umeiko/rpi2040-heimann-htpa32x32d-touchscreen/stl/button_x3.stl

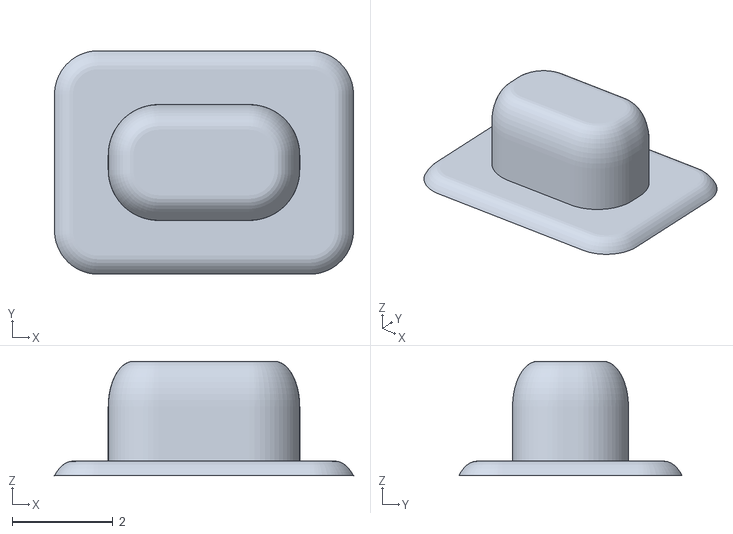
[picture p2: CAD file, 2025-01-20]
stl/button_x3.stl
5.93 x 4.43 x 2.27
