umeiko/rpi2040-heimann-htpa32x32d-touchscreen/stl/switch_x1.STL

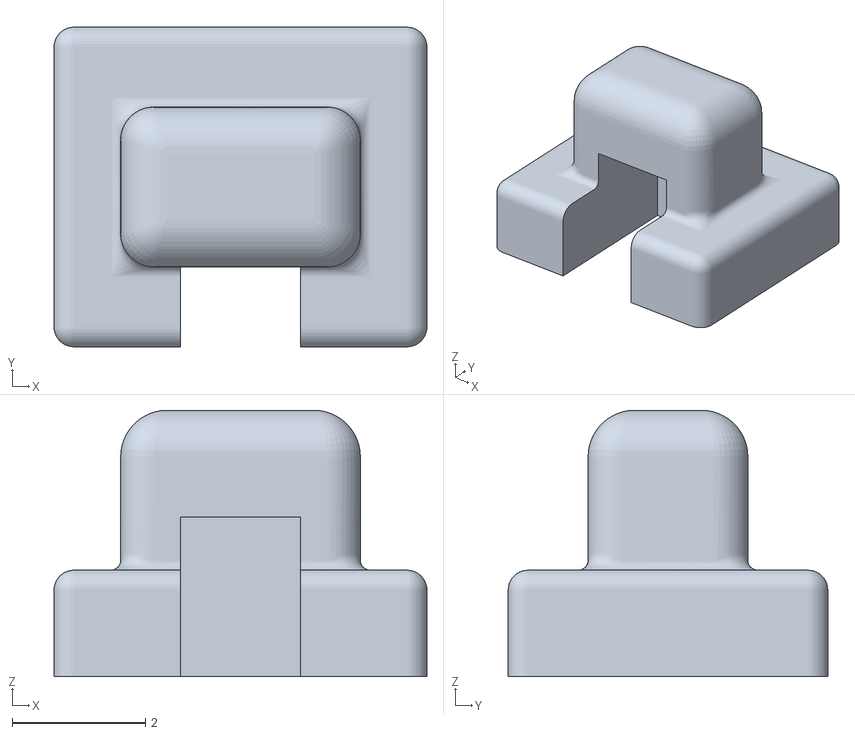
[picture p3: CAD file, 2025-01-20]
stl/switch_x1.STL
5.60 x 4.80 x 4.00
