umeiko/rpi2040-heimann-htpa32x32d-touchscreen/stl/shell2040_HAM.STL

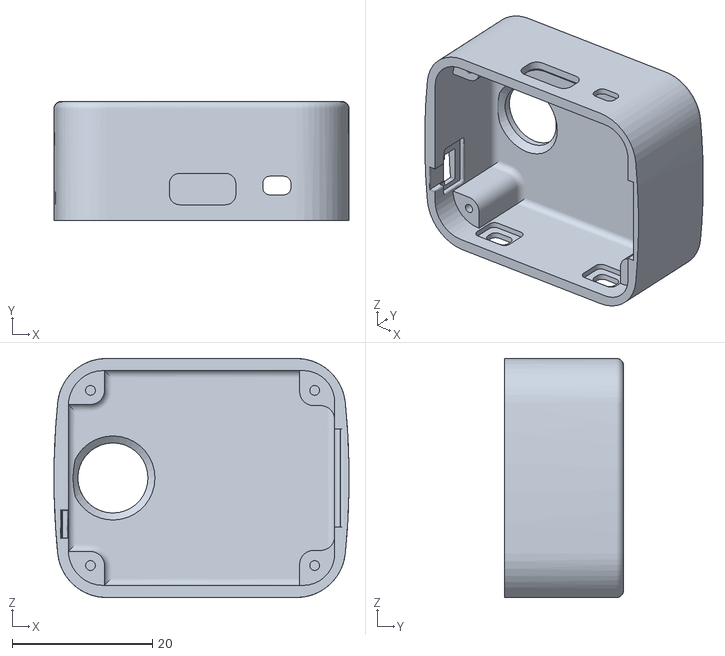
[picture p4: CAD file, 2025-01-20]
stl/shell2040_HAM.STL
42.1 x 17.0 x 34.1
