umeiko/rpi2040-heimann-htpa32x32d-touchscreen/stl/MLX垫子.STL

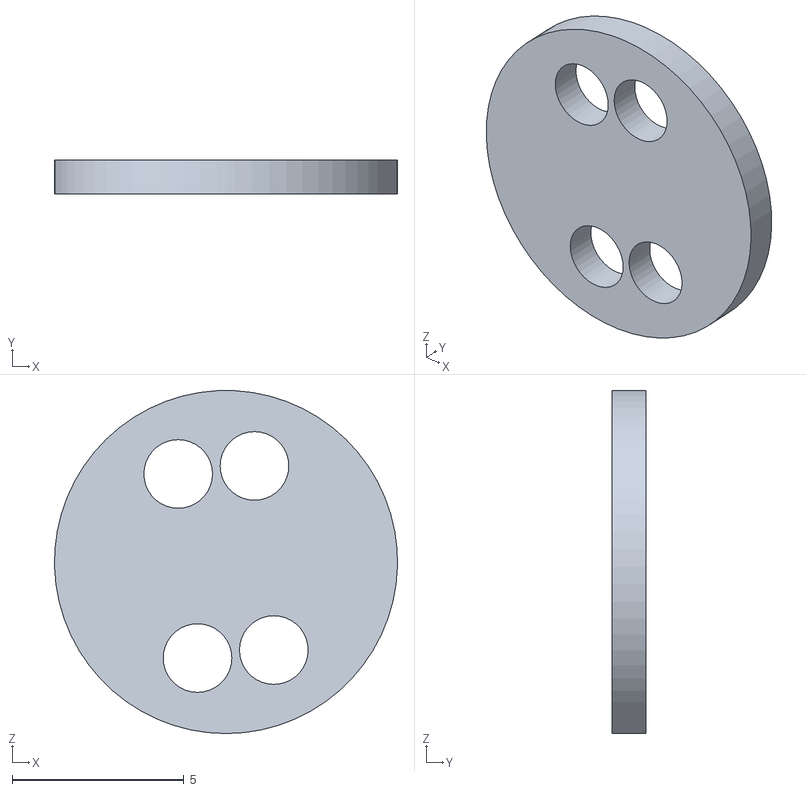
[picture p5: CAD file, 2025-01-20]
stl/MLX垫子.STL
10.00 x 1.00 x 10.0
