umeiko/rpi2040-heimann-htpa32x32d-touchscreen/pcb/Schematic.pdf

## Raspberry Pi

晶振

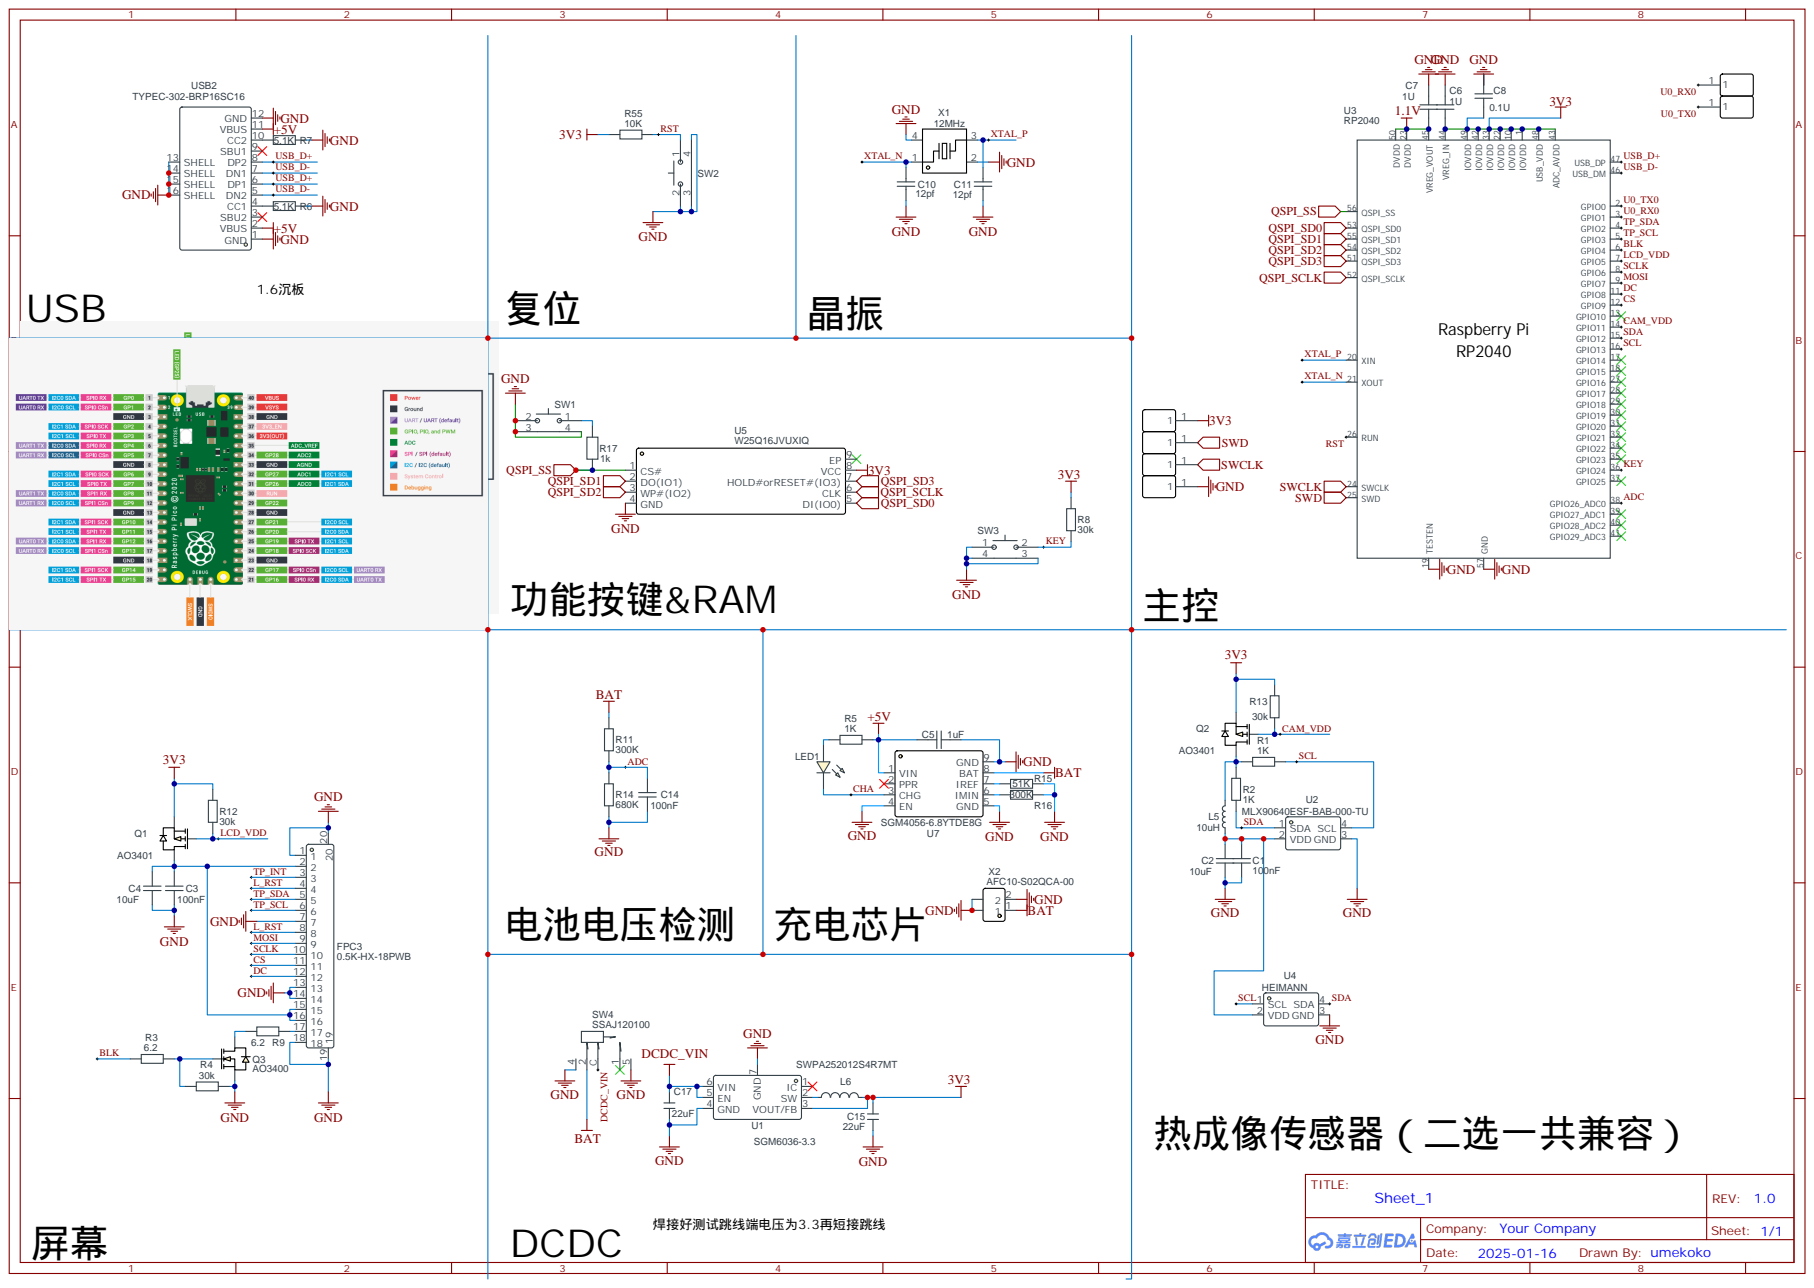
[picture p6: page 1]

SHELL 16 SHELL 15 SHELL 14 SHELL 13
