umeiko/rpi2040-heimann-htpa32x32d-touchscreen/(list of files, drawings)

Other design files:
pcb/PCB.pcbdoc
