umeiko/rpi2040-heimann-htpa32x32d-touchscreen/main/src/probe/def.h

#ifndef _def_H
#define _def_H

#include <Arduino.h>
// DEVICE ADRESS
#define  SENSOR_ADDRESS          0x1A
#define  EEPROM_ADDRESS          0x50

// I2C CLOCK
#define CLOCK_SENSOR            1000000 
#define CLOCK_EEPROM            400000


// SETTING
#define PTAT_BUFFER_SIZE 10
#define VDD_BUFFER_SIZE 10
#define ELOFFSETS_BUFFER_SIZE 10
#define ELOFFSETS_FILTER_START_DELAY  100
#define START_WITH_BLOCK 4
#define READ_ELOFFSET_EVERYX 10

// PARAMETER LOOKUPTABLE
#define TABLENUMBER 113      // table number of this sensor type
#define PCSCALEVAL 100000000 // scale value for PixC (see formula in datasheet)
#define NROFTAELEMENTS 7    // number of columns (ambient temperature steps)
#define NROFADELEMENTS 1595  // number of rows (digit steps)
#define TAEQUIDISTANCE 100   // distance between two columns
#define ADEQUIDISTANCE 64    // distance between two rows
#define ADEXPBITS 6
#define TABLEOFFSET 1024 // table offset in digits


// SENSOR INFO
#define NUMBER_OF_PIXEL 1024 // number of all pixels
#define NUMBER_OF_BLOCKS 4 // number of blocks for each half
#define PIXEL_PER_BLOCK 128 // number of pixels of each block
#define PIXEL_PER_COLUMN 32 // number of pixels of each column
#define PIXEL_PER_ROW 32 // number of pixels of each row
#define ROW_PER_BLOCK 4 // number of rows of each block
#define ALLOWED_DEADPIX 5 // max. 0.5% of the pixel number
#define ATC_ACTIVE 0 // 1 - sensor has... / 0 - sensor hasn't a cyclops
#define ATC_POS 0 // postion of the cyclops in block reading order
#define PTAT_POS 0 // position of PTAT in block reading order
#define VDD_POS 0 // postion of VDD in block reading order
#define PTAT_VDD_SWITCH 1 // 1 - PTAT and VDD alternate after each pic / 0 - not
#define BLOCK_LENGTH 258 // number of char in each block
#define DATA_POS 2  // position of first data byte in each block


// SENSOR REGISTER
#define TOP_HALF 0x0A // data of top half
#define BOTTOM_HALF 0x0B // data of bot half
#define CONFIGURATION_REGISTER 0x01 // configuration register (WRITE only)
// |  7  |  6  |  5  |  4  |   3   |    2     |   1   |    0   |
// |    RFU    |   Block   | Start | VDD_MEAS | BLIND | WAKEUP |
#define STATUS_REGISTER 0x02 // adress of status register (READ only)
// |  7  |  6  |  5  |  4  |   3   |    2     |   1   |    0   |
// |    RFU    |   Block   |  RFU  | VDD_MEAS | BLIND |   EOC  |
#define TRIM_REGISTER1 0x03 // adress for trim register 1 (WRITE only)
// |  7  |  6  |  5  |  4  |  3  |  2  |  1  |  0  |
// |    RFU    |  REF_CAL  |         MBIT          |
#define TRIM_REGISTER2 0x04 // adress for trim register 2 (WRITE only)
// |  7  |  6  |  5  |  4  |  3  |  2  |  1  |  0  |
// |       RFU       |       BIAS TRIM TOP         |
#define TRIM_REGISTER3 0x05 // adress for trim register 3 (WRITE only)
// |  7  |  6  |  5  |  4  |  3  |  2  |  1  |  0  |
// |       RFU       |       BIAS TRIM BOT         |
#define TRIM_REGISTER4 0x06 // adress for trim register 4 (WRITE only)
// |  7  |  6  |  5  |  4  |  3  |  2  |  1  |  0  |
// |       RFU |             CLK TRIM              |
#define TRIM_REGISTER5 0x07 // adress for trim register 5 (WRITE only)
// |  7  |  6  |  5  |  4  |  3  |  2  |  1  |  0  |
// |       RFU       |        BPA TRIM TOP         |
#define TRIM_REGISTER6 0x08 // adress for trim register 6 (WRITE only)
// |  7  |  6  |  5  |  4  |  3  |  2  |  1  |  0  |
// |       RFU       |       BPA TRIM BOT          |
#define TRIM_REGISTER7 0x09 // adress for trim register 7 (WRITE only)
// |  7  |  6  |  5  |  4  |  3  |  2  |  1  |  0  |
// |       PU SDA TRIM     |       PU SDA TRIM     |


// EEPROM REGISTER
#define E_PIXCMIN_1 0x0000 // Min of PixC, stored as float in four 8-bit fields
#define E_PIXCMIN_2 0x0001
#define E_PIXCMIN_3 0x0002
#define E_PIXCMIN_4 0x0003
#define E_PIXCMAX_1 0x0004// Max of PixC, stored as float in four 8-bit fields
#define E_PIXCMAX_2 0x0005
#define E_PIXCMAX_3 0x0006
#define E_PIXCMAX_4 0x0007
#define E_GRADSCALE 0x0008 // stored as unsigned char, important for PTAT comp.
#define E_TABLENUMBER1 0x000B // table number of this sensor, stored as unsigned short
#define E_TABLENUMBER2 0x000C
#define E_EPSILON 0x000D // emissivity in percentage, stored as unsigned char
#define E_MBIT_CALIB 0x001A // calibration settings of trim register 1
#define E_BIAS_CALIB 0x001B // calibration settings of trim register 2 & 3
#define E_CLK_CALIB 0x001C // calibration settings of trim register 4
#define E_BPA_CALIB 0x001D // calibration settings of trim register 5 & 6
#define E_PU_CALIB 0x001E // calibration settings of trim register 7
#define E_ARRAYTYPE 0x0022 // array type of this sensor
#define E_VDDTH1_1 0x0026 // HS calibration value
#define E_VDDTH1_2 0x0027 // HS calibration value
#define E_VDDTH2_1 0x0028 // HS calibration value
#define E_VDDTH2_2 0x0029 // HS calibration value
#define E_PTATGR_1 0x0034 // PTAT gradient stored as float in four 8-bit fields
#define E_PTATGR_2 0x0035
#define E_PTATGR_3 0x0036
#define E_PTATGR_4 0x0037
#define E_PTATOFF_1 0x0038 // PTAT offset stored as float in four 8-bit fields
#define E_PTATOFF_2 0x0039
#define E_PTATOFF_3 0x003A
#define E_PTATOFF_4 0x003B
#define E_PTATTH1_1 0x003C // HS calibration value
#define E_PTATTH1_2 0x003D // HS calibration value
#define E_PTATTH2_1 0x003E // HS calibration value
#define E_PTATTH2_2 0x003F // HS calibration value
#define E_VDDSCGRAD 0x004E // HS calibration value
#define E_VDDSCOFF 0x004F // HS calibration value
#define E_GLOBALOFF 0x0054 // global offset, stored as signed char
#define E_GLOBALGAIN_1 0x0055 // global gain, stored as unsigned short
#define E_GLOBALGAIN_2 0x0056
#define E_MBIT_USER 0x0060 // user settings of trim register 1
#define E_BIAS_USER 0x0061 // user settings of trim register 2 & 3
#define E_CLK_USER 0x0062 // user settings of trim register 4
#define E_BPA_USER 0x0063 // user settings of trim register 5 & 6
#define E_PU_USER 0x0064 // user settings of trim register 7
#define E_ID1 0x0074 // sensor idenification number, stored as unsigned long (1 of 4)
#define E_ID2 0x0075
#define E_ID3 0x0076
#define E_ID4 0x0077
#define E_NROFDEFPIX 0x007F // number of defekt pixel, stored as unsigned char
#define E_DEADPIXADR 0x0080 // first register of dead adress
#define E_DEADPIXMASK 0x00B0 // first register of dead pixel mask
#define E_VDDCOMPGRAD 0x0340 // first register of VDD comp gradient
#define E_VDDCOMPOFF 0x0540 // first register ofVDD comp offset
#define E_THGRAD 0x0740 // first register of thermal gradient
#define E_THOFFSET 0x0F40 // first register of thermal offset 
#define E_PIJ 0x1740 // first register of pixel constants (PixC)
#define EEPROM_SIZE 0x2000 // total number of EEPROM bytes

const unsigned char LUTshape[8][8] = {
  {0,0,0,0,0,0,0,0},
  {1,1,1,1,0,0,0,1},
  {0,1,0,0,0,0,0,1},
  {0,1,0,1,0,1,0,1},
  {0,1,0,1,0,1,0,1},
  {0,1,0,1,1,1,0,1},
  {0,1,0,0,0,0,0,1},
  {0,1,0,1,1,1,1,1},
};


const unsigned int TempTable [NROFADELEMENTS][NROFTAELEMENTS]={
{  0x0000, 0x0000, 483,  1384, 1759, 2037, 2269  },
{ 0x0000, 0x0000, 1183, 1621, 1920, 2162, 2372  },
{ 0x0000, 942,  1481, 1805, 2058, 2274, 2466  },
{ 567,  1340, 1694, 1959, 2181, 2376, 2555  },
{ 1201, 1589, 1865, 2092, 2291, 2471, 2638  },
{ 1492, 1779, 2011, 2211, 2392, 2559, 2716  },
{ 1703, 1937, 2138, 2319, 2485, 2641, 2790  },
{ 1872, 2073, 2252, 2418, 2572, 2719, 2860  },
{ 2017, 2194, 2356, 2509, 2654, 2793, 2927  },
{ 2144, 2303, 2452, 2595, 2731, 2863, 2992  },
{ 2257, 2403, 2542, 2675, 2805, 2930, 3053  },
{ 2361, 2496, 2625, 2751, 2874, 2995, 3113  },
{ 2457, 2582, 2704, 2824, 2941, 3056, 3170  },
{ 2546, 2663, 2779, 2892, 3005, 3116, 3226  },
{ 2629, 2740, 2850, 2958, 3066, 3173, 3279  },
{ 2708, 2813, 2917, 3021, 3125, 3228, 3331  },
{ 2782, 2882, 2982, 3082, 3182, 3282, 3382  },
{ 2853, 2948, 3044, 3140, 3237, 3334, 3431  },
{ 2920, 3012, 3104, 3197, 3290, 3384, 3479  },
{ 2985, 3073, 3162, 3252, 3342, 3433, 3525  },
{ 3047, 3132, 3217, 3304, 3392, 3481, 3571  },
{ 3107, 3188, 3271, 3356, 3441, 3528, 3615  },
{ 3164, 3243, 3324, 3406, 3489, 3573, 3659  },
{ 3220, 3296, 3374, 3454, 3535, 3617, 3701  },
{ 3274, 3348, 3424, 3501, 3580, 3661, 3742  },
{ 3326, 3398, 3472, 3547, 3624, 3703, 3783  },
{ 3377, 3447, 3518, 3592, 3667, 3744, 3823  },
{ 3426, 3494, 3564, 3636, 3710, 3785, 3862  },
{ 3474, 3540, 3609, 3679, 3751, 3824, 3900  },
{ 3521, 3585, 3652, 3721, 3791, 3863, 3937  },
{ 3566, 3629, 3694, 3762, 3831, 3902, 3974  },
{ 3611, 3672, 3736, 3802, 3870, 3939, 4010  },
{ 3654, 3714, 3777, 3841, 3908, 3976, 4046  },
{ 3696, 3755, 3817, 3880, 3945, 4012, 4081  },
{ 3738, 3796, 3856, 3918, 3982, 4048, 4115  },
{ 3779, 3835, 3894, 3955, 4018, 4083, 4149  },
{ 3818, 3874, 3932, 3991, 4053, 4117, 4183  },
{ 3857, 3912, 3969, 4027, 4088, 4151, 4215  },
{ 3896, 3949, 4005, 4063, 4122, 4184, 4248  },
{ 3933, 3986, 4041, 4097, 4156, 4217, 4280  },
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


const unsigned int XTATemps[NROFTAELEMENTS]={2782,  2882, 2982, 3082, 3182, 3282, 3382};
const unsigned int YADValues[NROFADELEMENTS]={0,  64, 128,  192,  256,  320,  384,  448,  512,  576,  640,  704,  768,  832,  896,  960,  1024, 1088, 1152, 1216, 1280, 1344, 1408, 1472, 1536, 1600, 1664, 1728, 1792, 1856, 1920, 1984, 2048, 2112, 2176, 2240, 2304, 2368, 2432, 2496, 2560, 2624, 2688, 2752, 2816, 2880, 2944, 3008, 3072, 3136, 3200, 3264, 3328, 3392, 3456, 3520, 3584, 3648, 3712, 3776, 3840, 3904, 3968, 4032, 4096, 4160, 4224, 4288, 4352, 4416, 4480, 4544, 4608, 4672, 4736, 4800, 4864, 4928, 4992, 5056, 5120, 5184, 5248, 5312, 5376, 5440, 5504, 5568, 5632, 5696, 5760, 5824, 5888, 5952, 6016, 6080, 6144, 6208, 6272, 6336, 6400, 6464, 6528, 6592, 6656, 6720, 6784, 6848, 6912, 6976, 7040, 7104, 7168, 7232, 7296, 7360, 7424, 7488, 7552, 7616, 7680, 7744, 7808, 7872, 7936, 8000, 8064, 8128, 8192, 8256, 8320, 8384, 8448, 8512, 8576, 8640, 8704, 8768, 8832, 8896, 8960, 9024, 9088, 9152, 9216, 9280, 9344, 9408, 9472, 9536, 9600, 9664, 9728, 9792, 9856, 9920, 9984, 10048,  10112,  10176,  10240,  10304,  10368,  10432,  10496,  10560,  10624,  10688,  10752,  10816,  10880,  10944,  11008,  11072,  11136,  11200,  11264,  11328,  11392,  11456,  11520,  11584,  11648,  11712,  11776,  11840,  11904,  11968,  12032,  12096,  12160,  12224,  12288,  12352,  12416,  12480,  12544,  12608,  12672,  12736,  12800,  12864,  12928,  12992,  13056,  13120,  13184,  13248,  13312,  13376,  13440,  13504,  13568,  13632,  13696,  13760,  13824,  13888,  13952,  14016,  14080,  1414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
98176,  98240,  98304,  98368,  98432,  98496,  98560,  98624,  98688,  98752,  98816,  98880,  98944,  99008,  99072,  99136,  99200,  99264,  99328,  99392,  99456,  99520,  99584,  99648,  99712,  99776,  99840,  99904,  99968,  100032, 100096, 100160, 100224, 100288, 100352, 100416, 100480, 100544, 100608, 100672, 100736, 100800, 100864, 100928, 100992, 101056, 101120, 101184, 101248, 101312, 101376, 101440, 101504, 101568, 101632, 101696, 101760, 101824, 101888, 101952, 102016};



// const unsigned short DLCOFFSET_LUT[10000] = { 0,  0,  0,  0,  0,  0,  0,  0,  0,  0,  0,  0,  0,  0,  0,  0,  0,  0,  0,  0,  0,  0,  0,  0,  0,  0,  0,  0,  0,  0,  0,  0,  0,  0,  0,  0,  0,  0,  0,  0,  0,  0,  0,  0,  0,  0,  0,  0,  0,  0,  0,  0,  0,  0,  0,  0,  0,  0,  0,  0,  0,  0,  0,  0,  0,  0,  0,  0,  0,  0,  0,  0,  0,  0,  0,  0,  0,  0,  0,  0,  0,  0,  0,  0,  0,  0,  0,  0,  0,  0,  0,  0,  0,  0,  0,  1,  1,  1,  1,  1,  1,  1,  1,  1,  1,  1,  1,  1,  1,  1,  1,  1,  1,  1,  1,  1,  1,  1,  1,  1,  1,  1,  1,  1,  1,  1,  1,  1,  1,  1,  1,  1,  1,  1,  1,  1,  1,  1,  1,  1,  1,  1,  1,  1,  1,  1,  1,  1,  1,  1,  1,  1,  1,  1,  1,  1,  1,  1,  1,  1,  1,  1,  1,  1,  1,  1,  1,  1,  1,  1,  1,  1,  1,  1,  1,  1,  1,  1,  1,  1,  1,  1,  1,  1,  1,  1,  1,  1,  1,  1,  1,  1,  1,  1,  1,  1,  1,  1,  1,  1,  1,  1,  1,  1,  1,  1,  1,  1,  1,  1,  1,  1,  1,  1,  1,  1,  1,  1,  1,  1,  1,  1,  1,  1,  1,  1,  1,  1,  1,  1,  1,  2,  2,  2,  2,  2,  2,  2,  2,  2,  2,  2,  2,  2,  2,  2,  2,  2,  2,  2,  2,  2,  2,  2,  2,  2,  2,  2,  2,  2,  2,  2,  2,  2,  2,  2,  2,  2,  2,  2,  2,  2,  2,  2,  2,  2,  2,  2,  2,  2,  2,  2,  2,  2,  2,  2,  2,  2,  2,  2,  2,  2,  2,  2,  2,  2,  2,  2,  2,  2,  2,  2,  2,  2,  2,  2,  2,  2,  2,  2,  2,  2,  2,  2,  2,  2,  2,  2,  2,  2,  2,  2,  2,  2,  2,  2,  2,  2,  2,  2,  2,  2,  2,  2,  2,  2,  2,  2,  2,  2,  2,  2,  2,  2,  2,  2,  2,  2,  2,  2,  2,  2,  2,  2,  2,  2,  3,  3,  3,  3,  3,  3,  3, 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


#endif // for #ifndef  _def_H
