umeiko/rpi2040-heimann-htpa32x32d-touchscreen/main/src/colormap.h

// 这里保存了热力图的颜色表，格式为rgb565
/*** PROGRAMM INFO***************************************************************************************
  source code for color mapping
  name:           colormap.h
  version/date:   0.0.1 / 01 Jan 2025
  programmer:     Umeko (umeko@stu.xmu.edu.cn)
*********************************************************************************************************/
#ifndef COLORMAP_H
#define COLORMAP_H

#include <Arduino.h>
#include "shared_val.h"

static uint16_t colormap[180];

uint16_t viridis[180] PROGMEM = {
0x400a, 0x400a, 0x400a, 0x400a, 0x400a, 0x400a, 0x402b, 0x402b, 0x404b, 0x404b, 
0x404b, 0x406b, 0x406b, 0x406c, 0x406c, 0x408c, 0x408c, 0x408c, 0x40ac, 0x40ac, 
0x40ad, 0x40ad, 0x48cd, 0x48cd, 0x48cd, 0x48cd, 0x48ed, 0x48ee, 0x48ee, 0x490e, 
0x490e, 0x490e, 0x490e, 0x490e, 0x490e, 0x412e, 0x412e, 0x412e, 0x414f, 0x414f, 
0x414f, 0x414f, 0x416f, 0x416f, 0x416f, 0x418f, 0x418f, 0x418f, 0x418f, 0x41af, 
0x41af, 0x41b0, 0x41b0, 0x41b0, 0x41d0, 0x41d0, 0x41d0, 0x41d0, 0x41f0, 0x41f0, 
0x41f0, 0x41f0, 0x4210, 0x4210, 0x4210, 0x4210, 0x4210, 0x4230, 0x4230, 0x3a31, 
0x3a31, 0x3a51, 0x3a51, 0x3a51, 0x3a51, 0x3a51, 0x3a71, 0x3a71, 0x3a71, 0x3a71, 
0x3a91, 0x3a91, 0x3a91, 0x3a91, 0x3a91, 0x3ab1, 0x3ab1, 0x3ab1, 0x3ab1, 0x3ab1, 
0x32d1, 0x32d1, 0x32d1, 0x32f1, 0x3311, 0x3311, 0x3331, 0x3331, 0x3351, 0x2b51, 
0x2b71, 0x2b71, 0x2b91, 0x2b91, 0x2bb1, 0x2bb1, 0x2bd1, 0x2bd1, 0x23f1, 0x23f1, 
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
0x4a69, 0x4a49, 0x4a49, 0x4228, 0x4228, 0x4208, 0x39e7, 0x39c7, 0x31a6, 0x31a6, 
0x3186, 0x2965, 0x2945, 0x2945, 0x2945, 0x2104, 0x2104, 0x18e3, 0x18e3, 0x18c3, 
0x18c3, 0x10a2, 0x1082, 0x1082, 0x0861, 0x0861, 0x0841, 0x0841, 0x0020, 0x0000
};

// 根据索引从程序存储器中复制数据到静态数组
void load_colormap(uint8_t index) {
    cmap_loading_lock = true;
    if (index == COLORMAP_CLASSIC) {
        memcpy_P(colormap, classic, sizeof(colormap));
    }else if (index == COLORMAP_VIRIDIS) {
        memcpy_P(colormap, viridis, sizeof(colormap));
    }else if(index == COLORMAP_HOT) {
        memcpy_P(colormap, hot, sizeof(colormap));
    }else if(index == COLORMAP_TURBO) {
        memcpy_P(colormap, turbo, sizeof(colormap));
    }else if(index == COLORMAP_INFERNO) {
        memcpy_P(colormap, inferno, sizeof(colormap));
    }else if(index == COLORMAP_GRAYSR) {
        memcpy_P(colormap, greys_r, sizeof(colormap));
    }else if(index == COLORMAP_GRAYS) {
        memcpy_P(colormap, greys, sizeof(colormap));
    }else{
        memcpy_P(colormap, classic, sizeof(colormap));
    }
    cmap_loading_lock = false;
}

void next_cmap(){
    cmap_now_choose+=1;
    if (cmap_now_choose>=COLORMAP_GRAYS){
        cmap_now_choose = COLORMAP_CLASSIC;
    }
    load_colormap(cmap_now_choose);
}

void priv_cmap(){
    if (cmap_now_choose==COLORMAP_CLASSIC){
        cmap_now_choose = COLORMAP_GRAYS;
    }else{
        cmap_now_choose-=1;
    }
    load_colormap(cmap_now_choose);
}

#endif // COLORMAP_H
