umeiko/rpi2040-heimann-htpa32x32d-touchscreen/main/src/logo_jpg.h

/*  Create C arrays from jpeg images
    If needed, first resize and crop to an appropriate width and height
    to suit your display with an image editing program such as IrfanView.
    You can also change the image "quality" to reduce the file size.
    Paste the array into a new tab, top and tail the array from the
    tool to look like the one below with:

        const uint8_t name[] PROGMEM = {

    to start and and end with:

   };
    Change the name of the array. Make sure the original jpeg is less than 32Kbyes
    as there is an array size limit imposed by the Arduino IDE!
*/

const uint8_t logo[] PROGMEM = {
0xFF, 0xD8, 0xFF, 0xE0, 0x00, 0x10, 0x4A, 0x46, 0x49, 0x46, 0x00, 0x01, 0x01, 0x01, 0x00, 0x60, 
0x00, 0x60, 0x00, 0x00, 0xFF, 0xE1, 0x00, 0x5A, 0x45, 0x78, 0x69, 0x66, 0x00, 0x00, 0x4D, 0x4D, 
0x00, 0x2A, 0x00, 0x00, 0x00, 0x08, 0x00, 0x05, 0x03, 0x01, 0x00, 0x05, 0x00, 0x00, 0x00, 0x01, 
0x00, 0x00, 0x00, 0x4A, 0x03, 0x03, 0x00, 0x01, 0x00, 0x00, 0x00, 0x01, 0x00, 0x00, 0x00, 0x00, 
0x51, 0x10, 0x00, 0x01, 0x00, 0x00, 0x00, 0x01, 0x01, 0x00, 0x00, 0x00, 0x51, 0x11, 0x00, 0x04, 
0x00, 0x00, 0x00, 0x01, 0x00, 0x00, 0x0E, 0xC3, 0x51, 0x12, 0x00, 0x04, 0x00, 0x00, 0x00, 0x01, 
0x00, 0x00, 0x0E, 0xC3, 0x00, 0x00, 0x00, 0x00, 0x00, 0x01, 0x86, 0xA0, 0x00, 0x00, 0xB1, 0x8F, 
0xFF, 0xDB, 0x00, 0x43, 0x00, 0x02, 0x01, 0x01, 0x02, 0x01, 0x01, 0x02, 0x02, 0x02, 0x02, 0x02, 
0x02, 0x02, 0x02, 0x03, 0x05, 0x03, 0x03, 0x03, 0x03, 0x03, 0x06, 0x04, 0x04, 0x03, 0x05, 0x07, 
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
0x36, 0x37, 0x38, 0x39, 0x3A, 0x43, 0x44, 0x45, 0x46, 0x47, 0x48, 0x49, 0x4A, 0x53, 0x54, 0x55, 
0x56, 0x57, 0x58, 0x59, 0x5A, 0x63, 0x64, 0x65, 0x66, 0x67, 0x68, 0x69, 0x6A, 0x73, 0x74, 0x75, 
0x76, 0x77, 0x78, 0x79, 0x7A, 0x82, 0x83, 0x84, 0x85, 0x86, 0x87, 0x88, 0x89, 0x8A, 0x92, 0x93, 
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
